feixingzhe9/bestfu-dev-ASP3-2/28.ASP3-2-开关控制执行器/Trunk/升级包及升级说明/Readme.txt

**********************************************************************************************
                   开关控制执行器版本说明 -- ASP3-2 (设备类型号：0x1c) 源程序			      
                          128K A地址  0x8000800
                          128K B地址  0x800C400
**********************************************************************************************
==============================================================================================
软件版本: V3.00.00
硬件版本：ASP3  V1.0
库 版 本：V1.20.00
修改内容：1、升级单区库版本；
修 改 者：周雁
修改时间：2016/05/11
==============================================================================================

==============================================================================================
软件版本: V1.00.00
硬件版本：ASP3  V1.0
库 版 本：None
修改内容：1、A/B区过渡升级单区必备升级包2；
修 改 者：周雁
修改时间：2016/05/11
==============================================================================================

==============================================================================================
软件版本: V0.99.99
硬件版本：ASP3  V1.0
库 版 本：V1.02.28(特别版)
修改内容：1、A/B区过渡升级单区必备升级包1；
修 改 者：周雁
修改时间：2016/05/11
==============================================================================================

==============================================================================================
软件版本: V2.10.04
硬件版本：ASP3  V1.0
库 版 本：V1.02.00
修改内容：1、修改系统库部分bug;
修 改 者：周雁
修改时间：2016/03/23
==============================================================================================

==============================================================================================
软件版本: V2.10.03
硬件版本：ASP3  V1.0
库 版 本：V1.02.00
修改内容：1、修改按键属性单元Get按键状态资源的一个bug;
修 改 者：周雁
修改时间：2016/03/23
==============================================================================================

==============================================================================================
软件版本: V2.10.02
硬件版本：ASP3  V1.0
库 版 本：V1.02.00
修改内容：1、替换大版本的库V1.2.0，详情参阅V1.2.0的库修改内容；
修 改 者：周雁
修改时间：2016/03/21
==============================================================================================

==============================================================================================
软件版本: V2.10.01
硬件版本：ASP3  V1.0
库 版 本：V1.02.00
修改内容：1、替换大版本的库V1.2.0，详情参阅V1.2.0的库修改内容；
	  2、增加按键的防捣蛋功能；
修 改 者：周雁
修改时间：2015/11/18
==============================================================================================

==============================================================================================
软件版本: V2.10.00
硬件版本：ASP3  V1.0
库 版 本：V1.01.25
修改内容：库版本升级，注意此版本后增加地址重设功能;
	  升级此版本需要升级过度版本V0.88.88
修 改 者：周雁
修改时间：2015/11/18
==============================================================================================
==============================================================================================
软件版本: V2.00.00
硬件版本：ASP3 V1.0
库 版 本：V1.01.24
修改内容：按照属性文档与需求文档代码的编写。
修 改 者：周雁
修改时间：2015/11/03
==============================================================================================
