feixingzhe9/bestfu-dev-ASP3-2/28.ASP3-2-开关控制执行器/文档/开关控制执行器（3-2路）公壳标签.docx

开关控制执行器

1）、每路开和关状态均可配置独立的场景

2）、支持两路独立开关控制和一路独立专用场景控制

3）、每个按键均有独立的背光指示灯

4）、433MHz无线组网通信

5）、具有负载过流保护功能

6）、可使用APP植入用户思想
