feixingzhe9/bestfu-dev-ASP3-2/28.ASP3-2-开关控制执行器/硬件/ASP3原理图.pdf

D

6 | 5 | 4 | 3 | 2 | 1

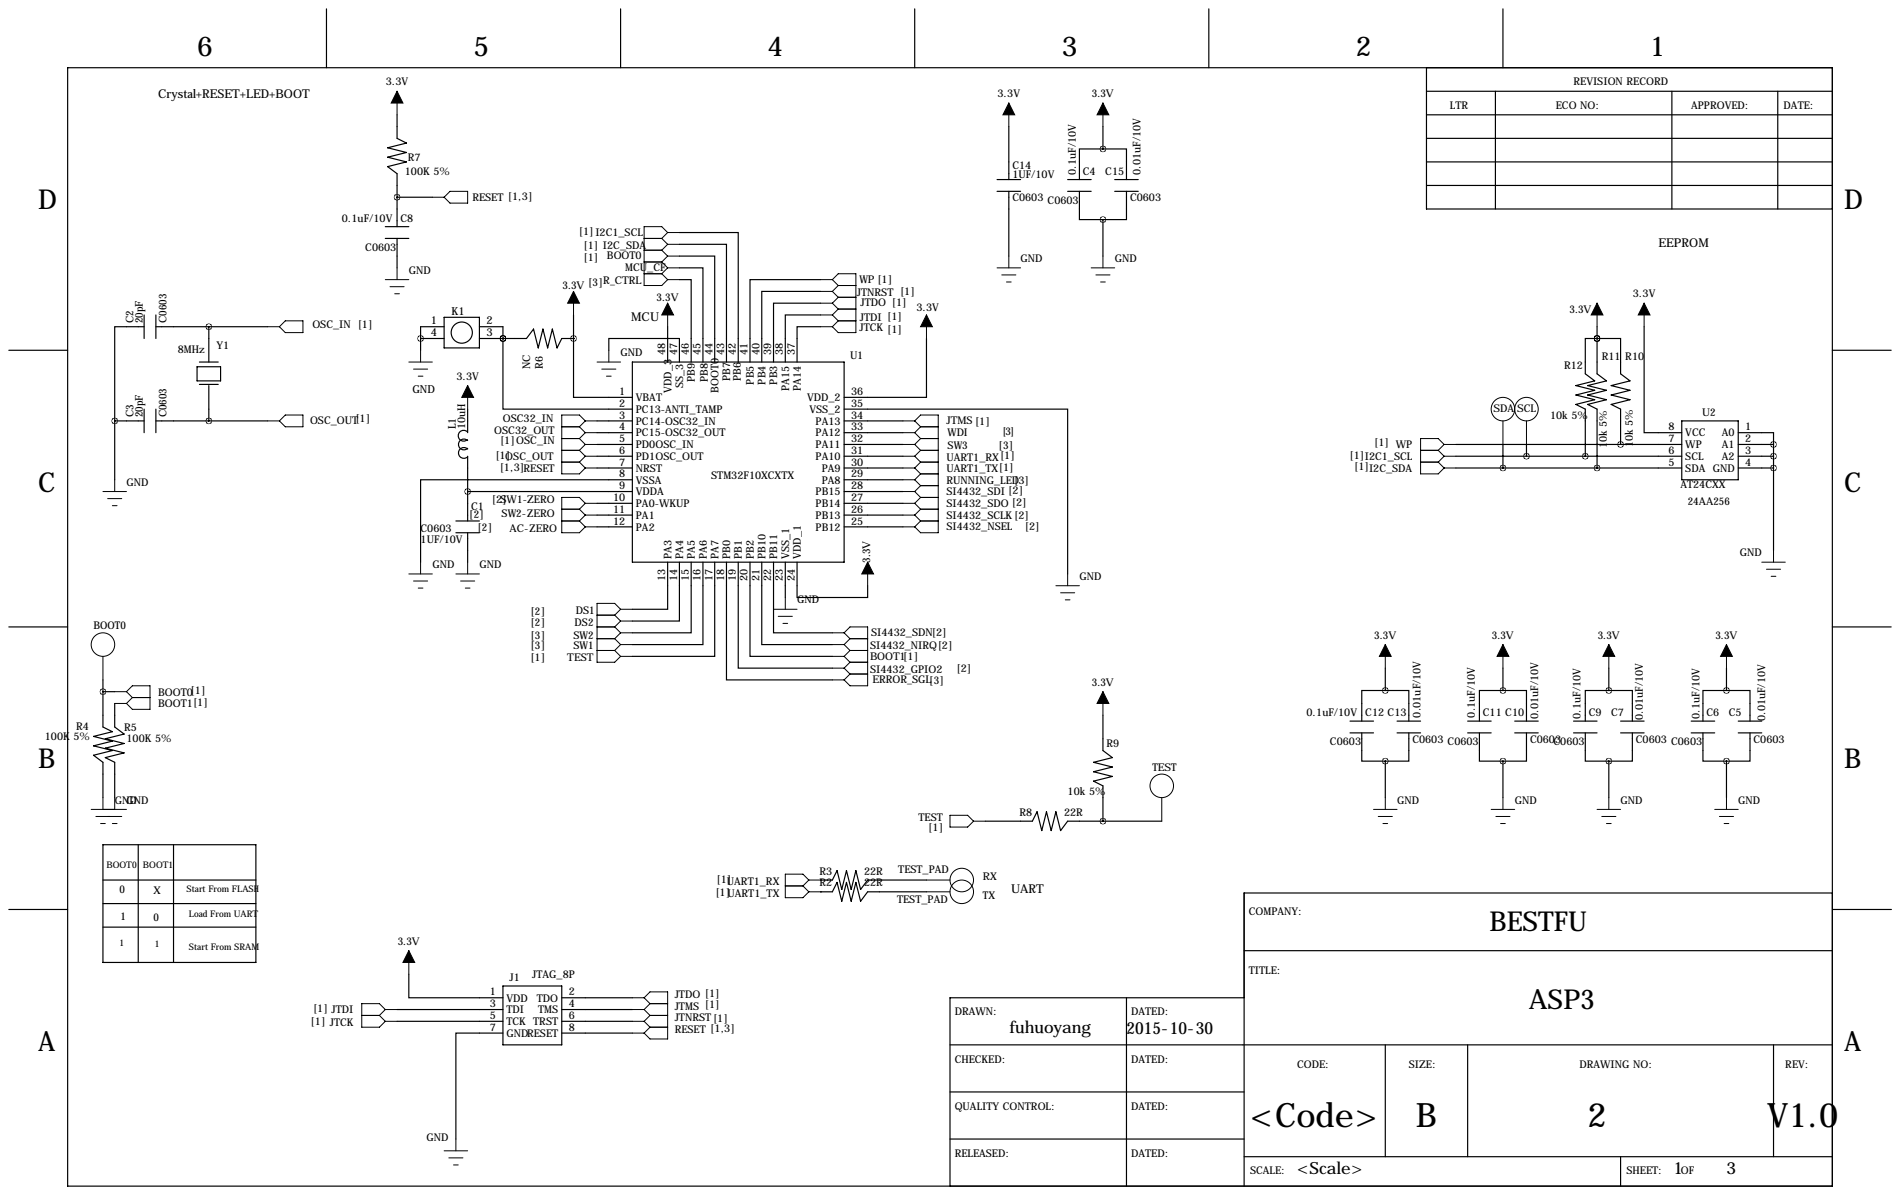
[picture p3: page 1]

REVISION RECORD

Crystal+RESET+LED+BOOT

LTR | ECO NO: | APPROVED: | DATE:

BOOT0 | BOOT1

0 | X | Start From FLASH

1 | 0 | Load From UART

1 | 1 | Start From SRAM

CHECKED: | DATED: | CODE: | SIZE: | DRAWING NO: | REV:

QUALITY CONTROL: | DATED:

RELEASED: | DATED:

<Scale> SCALE: | 1 3 SHEET: OF

D

D

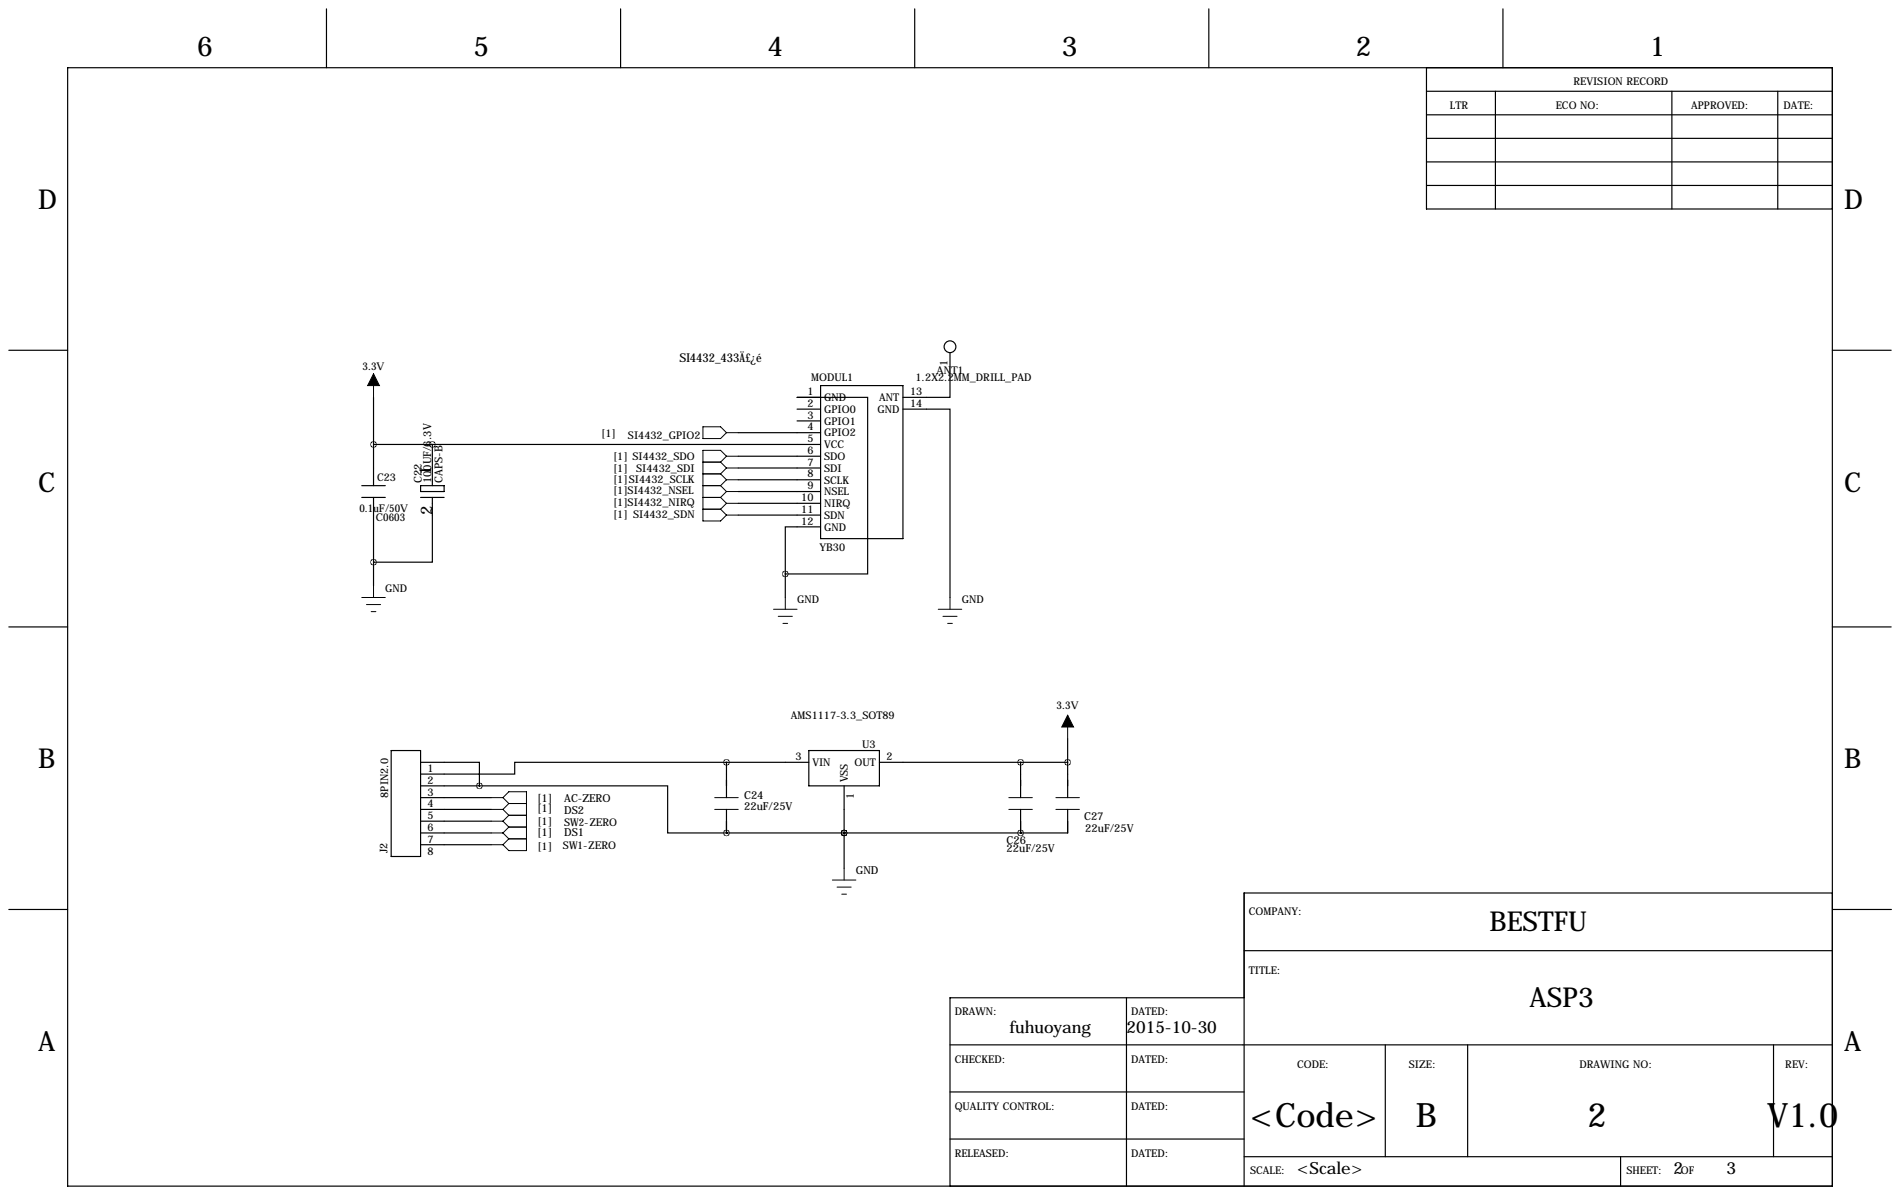
[picture p4: page 2]

REVISION RECORD

LTR | ECO NO: | APPROVED: | DATE:

DRAWN: fuhuoyang | DATED: 2015-10-30

CHECKED: | DATED: | CODE: | SIZE: | DRAWING NO: | REV:

QUALITY CONTROL: | DATED:

D

D

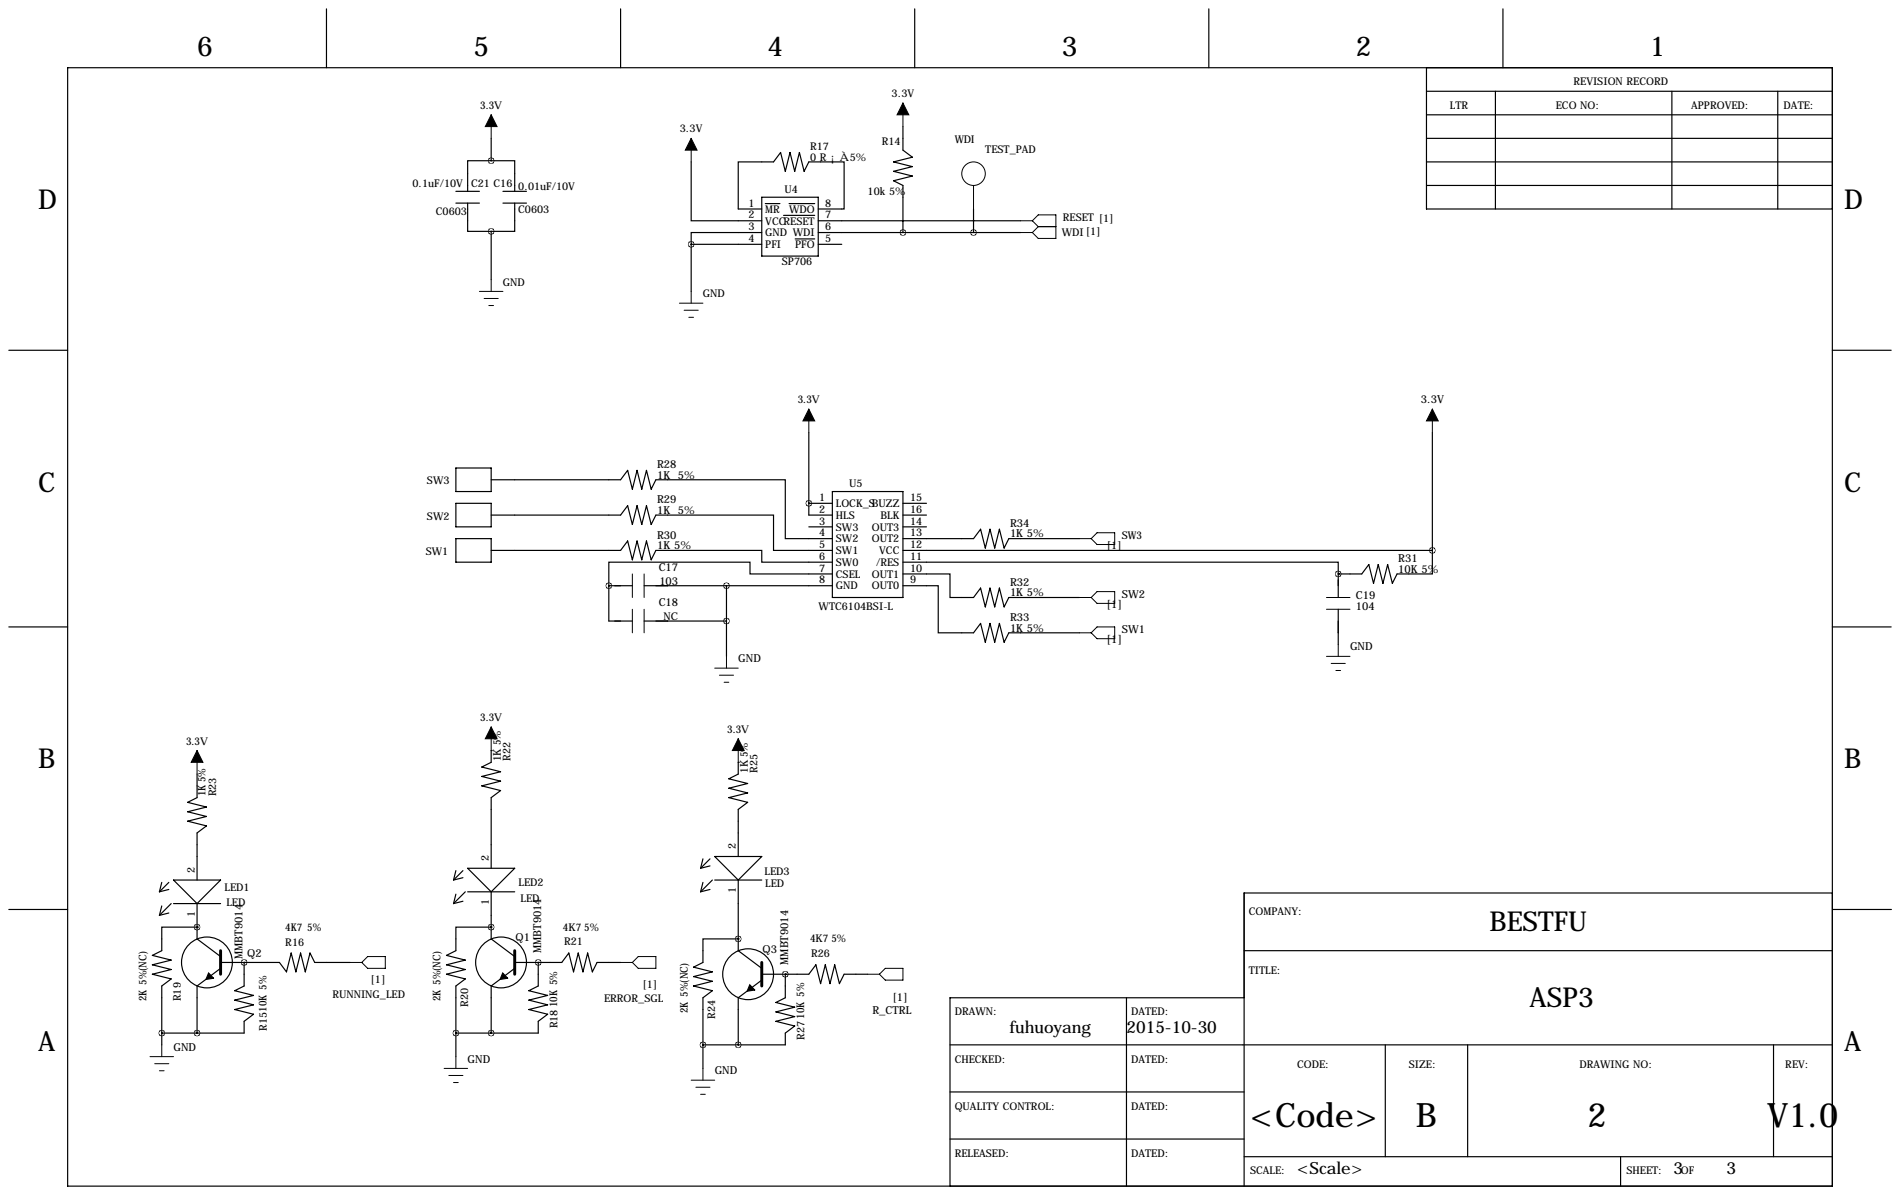
[picture p5: page 3]

REVISION RECORD

LTR | ECO NO: | APPROVED: | DATE:

DRAWN: fuhuoyang | DATED: 2015-10-30

CHECKED: | DATED: | CODE: | SIZE: | DRAWING NO: | REV:

QUALITY CONTROL: | DATED:
