feixingzhe9/bestfu-dev-ASP3-2/(list of files, drawings)

Other design files:
28.ASP3-2-开关控制执行器/硬件/三按键.pcb
