feixingzhe9/bestfu-dev-ASP3-2/28.ASP3-2-开关控制执行器/Branches/Transition Upgrade package SRC/SRC/Lib_code/SysHard/inc/Sys.h

/***************************Copyright BestFu 2014-05-14*************************
文	件：    Sys.h
说	明：    STM32内核相关设备函数
编	译：    Keil uVision4 V4.54.0.0
版	本：    v1.0
编	写：    Unarty
日	期：    2013-08-24
修　改：	暂无
*******************************************************************************/
#ifndef __SYS_H
#define __SYS_H	 

#include "stm32f10x.h"
#include "BF_type.h"	  

#define NVIC_VectTab_RAM             ((uint32_t)0x20000000)
#define NVIC_VectTab_FLASH           ((uint32_t)0x08000000)
#define IS_NVIC_VECTTAB(VECTTAB) (((VECTTAB) == NVIC_VectTab_RAM) || \
                                  ((VECTTAB) == NVIC_VectTab_FLASH))
#define IS_NVIC_OFFSET(OFFSET)  ((OFFSET) < 0x0005FFFF)
///////////////////////////////////////////////////////////////
//位带操作,实现51类似的GPIO控制功能
//具体实现思想,参考<<CM3权威指南>>第五章(87页~92页).
//IO口操作宏定义
#define BITBAND(addr, bitnum) ((addr & 0xF0000000)+0x2000000+((addr &0xFFFFF)<<5)+(bitnum<<2)) 
#define MEM_ADDR(addr)  *((volatile unsigned long  *)(addr)) 
#define BIT_ADDR(addr, bitnum)   MEM_ADDR(BITBAND(addr, bitnum)) 
//IO口地址映射
#define GPIOA_ODR_Addr    (GPIOA_BASE+12) //0x4001080C 
#define GPIOB_ODR_Addr    (GPIOB_BASE+12) //0x40010C0C 
#define GPIOC_ODR_Addr    (GPIOC_BASE+12) //0x4001100C 
#define GPIOD_ODR_Addr    (GPIOD_BASE+12) //0x4001140C 
#define GPIOE_ODR_Addr    (GPIOE_BASE+12) //0x4001180C 
#define GPIOF_ODR_Addr    (GPIOF_BASE+12) //0x40011A0C    
#define GPIOG_ODR_Addr    (GPIOG_BASE+12) //0x40011E0C    

#define GPIOA_IDR_Addr    (GPIOA_BASE+8) //0x40010808 
#define GPIOB_IDR_Addr    (GPIOB_BASE+8) //0x40010C08 
#define GPIOC_IDR_Addr    (GPIOC_BASE+8) //0x40011008 
#define GPIOD_IDR_Addr    (GPIOD_BASE+8) //0x40011408 
#define GPIOE_IDR_Addr    (GPIOE_BASE+8) //0x40011808 
#define GPIOF_IDR_Addr    (GPIOF_BASE+8) //0x40011A08 
#define GPIOG_IDR_Addr    (GPIOG_BASE+8) //0x40011E08 
 
//IO口操作,只对单一的IO口!
//确保n的值小于16!
#define PAout(n)   BIT_ADDR(GPIOA_ODR_Addr,n)  //输出 
#define PAin(n)    BIT_ADDR(GPIOA_IDR_Addr,n)  //输入 

#define PBout(n)   BIT_ADDR(GPIOB_ODR_Addr,n)  //输出 
#define PBin(n)    BIT_ADDR(GPIOB_IDR_Addr,n)  //输入 

#define PCout(n)   BIT_ADDR(GPIOC_ODR_Addr,n)  //输出 
#define PCin(n)    BIT_ADDR(GPIOC_IDR_Addr,n)  //输入 

#define PDout(n)   BIT_ADDR(GPIOD_ODR_Addr,n)  //输出 
#define PDin(n)    BIT_ADDR(GPIOD_IDR_Addr,n)  //输入 

#define PEout(n)   BIT_ADDR(GPIOE_ODR_Addr,n)  //输出 
#define PEin(n)    BIT_ADDR(GPIOE_IDR_Addr,n)  //输入

#define PFout(n)   BIT_ADDR(GPIOF_ODR_Addr,n)  //输出 
#define PFin(n)    BIT_ADDR(GPIOF_IDR_Addr,n)  //输入

#define PGout(n)   BIT_ADDR(GPIOG_ODR_Addr,n)  //输出 
#define PGin(n)    BIT_ADDR(GPIOG_IDR_Addr,n)  //输入
/////////////////////////////////////////////////////////////////
//Ex_NVIC_Config专用定义
#define FTIR   1  //下降沿触发
#define RTIR   2  //上升沿触发

#define  CPU_SR_ALLOC()        u32  cpu_sr = (u32)0
#define  CPU_INT_DIS()         do { cpu_sr = CPU_SR_Save(); } while (0) /* Save    CPU status word & disable interrupts.*/
#define  CPU_INT_EN()          do { CPU_SR_Restore(cpu_sr); } while (0) /* Restore CPU status word.                     */

#define  CPU_CRITICAL_ENTER()  do { CPU_INT_DIS(); } while (0)          /* Disable   interrupts.                        */
#define  CPU_CRITICAL_EXIT()   do { CPU_INT_EN();  } while (0)          /* Re-enable interrupts.  */
	

/////////////////////////////////////////////////////////////////
//JTAG模式设置定义
#define JTAG_SWD_DISABLE   0X02
#define SWD_ENABLE         0X01
#define JTAG_SWD_ENABLE    0X00	

/////////////////////////////////////////////////////////////////  
void DisableIRQ(void);
void EnableIRQ(void);
void Stm32_Clock_Init(u8 PLL);  //时钟初始化  
void Sys_Soft_Reset(void);      //系统软复位
void Sys_Standby(void);         //待机模式 	
void MY_NVIC_SetVectorTable(u32 NVIC_VectTab, u32 Offset);//设置偏移地址
void MY_NVIC_PriorityGroupConfig(u8 NVIC_Group);//设置NVIC分组
void MY_NVIC_Init(u8 NVIC_PreemptionPriority,u8 NVIC_SubPriority,u8 NVIC_Channel,u8 NVIC_Group);//设置中断
void Ex_NVIC_Config(u8 GPIOx,u8 BITx,u8 TRIM);//外部中断配置函数(只对GPIOA~G)
void JTAG_Set(u8 mode);
//////////////////////////////////////////////////////////////////////////////
//以下为汇编函数
void WFI_SET(void);		//执行WFI指令
void INTX_DISABLE(void);//关闭所有中断
void INTX_ENABLE(void);	//开启所有中断
void MSR_MSP(u32 addr);	//设置堆栈地址
u32 CPU_SR_Save(void);
void CPU_SR_Restore(u32 cpu_sr);

#endif
/**************************Copyright BestFu 2014-05-14*************************/
