feixingzhe9/bestfu-dev-ASP3-2/28.ASP3-2-开关控制执行器/Branches/Transition Upgrade package SRC/SRC/Lib_code/SysHard/Usart.c

/***************************Copyright BestFu 2014-05-14*************************
文	件：	UART.c
说	明：	串口操作相关函数
编	译：	Keil uVision4 V4.54.0.0
版	本：	v1.0
编	写：	Unarty
日	期：	2014.07.03 
修　改：	暂无
*******************************************************************************/
#include "sys.h"
#include "usart.h"	 
#include "Bf_type.h"
#include "cmdProcess.h"


/*******************************************************************************
函 数 名：	UART_Init
功能说明：	串口初始化
参	  数：	pclk2： 时钟频率（单位M）
			bound： 通信波特率
返 回 值：	无
*******************************************************************************/ 
void UART_Init(u32 pclk2, u32 bound)
{  			  
	RCC->APB2RSTR |= 1<<14;   	//复位串口1
	RCC->APB2RSTR &= ~(1<<14);	//停止复位 

	RCC->APB2ENR |= 1<<2;   	//使能PORTA口时钟  
	RCC->APB2ENR |= 1<<14;  	//使能串口时钟 

	GPIOA->CRH &= 0XFFFFF00F; 
	GPIOA->CRH |= 0X000008B0;	//IO状态设置
		   	   
	//波特率设置
 	USART1->BRR = (pclk2*1000000)/(bound); // 波特率设置	 
	USART1->CR1 |= 0X200C;  	//1位停止,无校验位.

	USART1->CR1 |= 1<<8;    	//PE中断使能
	USART1->CR1 |= 1<<5;    	//接收缓冲区非空中断使能	    	
	MY_NVIC_Init(3, 3, USART1_IRQn, 2);//组2，最低优先级 
}
 	
/*******************************************************************************
函 数 名：	UART_Send
功能说明：	串口数据发送
参	  数：	*data: 要发送的数内容
			len :	数据长度
返 回 值：	发送结果 TRUE/FALSE
*******************************************************************************/ 
u8 UART_Send(u8 *data, u8 len, u8 level)
{
	while (len--)
	{
		if (!UART_Write(*data++))
		{
			UART_Init(72, 9600);
		}
	}

	return TRUE;
}

/*******************************************************************************
函 数 名：	UART_WriteBit
功能说明：	串口写入一个字节数据 
参	  数：	ch:	要写入的数据
返 回 值：	写入结果TRUE/FALSE
*******************************************************************************/ 
u8 UART_Write(u8 c)
{   
	u32 t;
	
	for (t = 0; ((USART1->SR&0X40) == 0)&&(t < 20000); t++)   //等待数据发送完毕
	{}	
		
	if (t < 20000)  //未超时
	{
		USART1->DR = (u8)c;
		return TRUE;
	}
	      
	return FALSE;
}

/*******************************************************************************
函 数 名：	USART1_IRQHandler
功能说明：	串口中断处理
参	  数：	无
返 回 值：	无
*******************************************************************************/ 
void USART1_IRQHandler(void)
{
	if(USART1->SR&(1<<5))//接收到数据
	{	 
		fifo_putc(&rcv433fifo, USART1->DR);
	}

}

/**************************Copyright BestFu 2014-05-14*************************/
