feixingzhe9/bestfu-dev-ASP3-2/28.ASP3-2-开关控制执行器/Trunk/SRC/Lib_code/SysHard/SysTick.c

/***************************Copyright BestFu 2014-05-14*************************
文	件：	SysTick.c
说	明：	系统滴答
编	译：	Keil uVision4 V4.54.0.0
版	本：	v1.0
编	写：	Unarty
日	期：	2013-12-20
修　改：	暂无
*******************************************************************************/
#include "stm32f10x.h"
#include "SysTick.h"
#include "Thread.h"

//Priivate variable define 
static TimeFlag timer;
static u32 RandTime ;

/*******************************************************************************
函 数 名：	SysTick_Init
功能说明： 	Cotex_M3 系统滴答初始化
参	  数： 	sysClock： 系统时钟(单位：M)
返 回 值：	无
注    意:   系统初始化后将产生1ms系统滴答中断
*******************************************************************************/
void SysTick_Init(void)
{	
	u32 frq = 0u;
	u8 clksrc = 0u;
	
	Get_SysClk_FrqAndSrc(&frq,&clksrc);
	SysTick->CTRL &= 0xfffffffb;   //bit2清空,选择外部时钟  HCLK/8	
//	SysTick->CTRL |= 1<<2;   //bit2 set,选择内部时钟  
	SysTick->LOAD = frq/(1000*8); //1ms	  		 
	SysTick->VAL = 0x00;           //清空计数器
	SysTick->CTRL = 0x03;          //开启中断响应,开始倒数
	timer._1ms = 0; 
}

/*******************************************************************************
函 数 名：	Time_Get
功能说明： 	获取当前时间
参	  数： 	无
返 回 值：	当前计数值
*******************************************************************************/
u32 Time_Get(void)
{
    return timer._1ms;
}
/*******************************************************************************
函 数 名：	UpdateRandomTime
功能说明： 	更新随机时间点
参	  数： 	无
返 回 值：	无
注    意：  该时间点在指令处理流程中更新
*******************************************************************************/
void UpdateRandomTime(void)
{
	RandTime = timer._1ms ;
}
/*******************************************************************************
函 数 名：	GetRandomTime
功能说明： 	获取随机时间点
参	  数： 	无
返 回 值：	无
注    意：  因此可认为是随机时间点，使用者可作为随机数调用。
*******************************************************************************/
u32 GetRandomTime(void)
{
	return RandTime ;
}
/*******************************************************************************
** 函数名称: 	SysTick_Handler
** 功能描述: 	系统滴答中断服务程序
** 输　  入:   	无
** 返    回:   	无
*******************************************************************************/
void SysTick_Handler(void)
{
	timer._1ms %= TIME_MAX;	//最大记数1000s
	timer._1ms++;
	Thread_RunCheck();
}
/**************************Copyright BestFu 2014-05-14*************************/
