feixingzhe9/bestfu-dev-ASP3-2/28.ASP3-2-开关控制执行器/Trunk/SRC/Lib_code/SysHard/inc/Instruct.h

/***************************Copyright BestFu 2014-05-14*************************
文	件：	Insturct.h
说	明：	系统一些运行状态的，指示函数
编	译：	Keil uVision4 V4.54.0.0
版	本：	v1.0
编	写：	Unarty
日	期：	2014.06.30 
修　改：	暂无
*******************************************************************************/
#ifndef __INSTURCT_H
#define __INSTURCT_H

#include "BF_type.h"


void Instruct_Init(void);
void Instruct_Run(void);
void Instruct(void);

#endif	//Insturct.h end 
/**************************Copyright BestFu 2014-05-14*************************/
