feixingzhe9/bestfu-dev-ASP3-2/28.ASP3-2-开关控制执行器/Branches/Transition Upgrade package SRC/SRC/Lib_code/SysHard/inc/Test.h

/***************************Copyright BestFu 2014-05-14*************************
文	件：	Test.h
说	明：	测试函数头文件
编	译：	Keil uVision4 V4.54.0.0
版	本：	v1.0
编	写：	Unarty
日	期：	2014.07.03 
修　改：	暂无
*******************************************************************************/
#ifndef __TEST_H
#define __TEST_H

#include "BF_type.h"

#define TEST_STATE		(0x5a5a5a5a)

extern u32 Test;

void Test_Init(void);

#endif		//Test.h end 
/**************************Copyright BestFu 2014-05-14*************************/
