feixingzhe9/bestfu-dev-ASP3-2/28.ASP3-2-开关控制执行器/Trunk/BootLoader_1_Library/STM32F103_Medium/SysHard/include/Delay.h

/***************************Copyright BestFu 2014-05-14*************************
文	件：	Delay.h
说	明：	简单的时间延时函数头文件
编	译：	Keil uVision4 V4.54.0.0
版	本：	v1.0
编	写：	Unarty
日	期：	2013-12-23
修  改:     暂无
*******************************************************************************/
#ifndef __DELAY_H
#define __DELAY_H 	


void delay_ms(BF_INT32U ms);
void delay_us(BF_INT32U us);

#endif	//delay.h end


/**************************Copyright BestFu 2014-05-14*************************/
