feixingzhe9/bestfu-dev-ASP3-2/28.ASP3-2-开关控制执行器/Trunk/BootLoader_1_Library/STM32F103_Medium/SysHard/include/Eeprom.h

/***************************Copyright BestFu 2014-05-14*************************
文	件：	Eeprom.h
说	明：	对Eeprom操作,包括全局参数与EEPROM映射关系，独立读写EEPROM入口头文件
编	译：	Keil uVision4 V4.54.0.0
版	本：	v1.0
编	写：	Joey
日	期：	2013.7.23   
修  改:     暂无
*******************************************************************************/
#ifndef _EEPROM_H_
#define _EEPROM_H_

/*********************************自定义宏*************************************/
#define  A24C256               (256*1024/8)                 // 24C256大小
#define  EEPROMSIZE            (A24C256-EEPROMSTARTADDR)    // EEPROM尺寸
#define  PAGESIZE              (64)                         // 页尺寸
#define  I2CBUFFLEN            (PAGESIZE)                   // 写缓冲区大小
#define  EEPROMSTARTADDR       (100)                        // EEPROM器件首地址
#define  EEPROMENDADDR         (A24C256)                    // EEPROM器件尾地址
#define  EEPROMSLAVEADDR       (0xA0)                       // EEPROM从器件地址

#define  EEPROMUPGRADEADDR	   (0x2D00)						//存储升级断点的缓冲区地址

#define  EEPROMINITED          0xA5

/*********************************函数声明*************************************/
BF_BOOLEAN ReadDataFromEEPROM(BF_INT32U addr, BF_INT32U len, BF_INT08U *data);
BF_BOOLEAN WriteDataToEEPROM(BF_INT32U addr, BF_INT32U len, BF_INT08U *data);
BF_BOOLEAN WriteDataToEEPROMEx(BF_INT32U addr, BF_INT32U len, BF_INT08U data);

#endif
/**************************Copyright BestFu 2014-05-14*************************/
