feixingzhe9/bestfu-dev-ASP3-2/28.ASP3-2-开关控制执行器/Trunk/BootLoader_1_Library/STM32F103_Medium/SysHard/include/cpu_cfg.h

#ifndef  CPU_CFG_MODULE_PRESENT
#define  CPU_CFG_MODULE_PRESENT

/*
You need to define the macro,if CPU state need to save.

*/
#define  CPU_CRITICAL_METHOD_STATUS_LOCAL

/*
Be very careful here, you can modyfy the following code, if only you understand what yor are doing!

*/
#define  CPU_CFG_TS_TMR_SIZE                    CPU_WORD_SIZE_32

#endif
/***************************************************End of File*****************************************************/
